kcuzner/pop-n-music-controller/README.md

# Pop 'n Music PSX Controller
### Kevin Cuzner

AVR-based controller for the Pop 'n Music game supporting both native and
emulator modes.

## Goals

* Recognized as a native controller by the PS1 version of the game
* Recognized as a valid controller by the emulated version of the game

## Notes

### Cable

* Yellow: ATT
* Red: VCC
* Black: GND
* Blue: CLK
* Orange: COMMAND
* Green: ACK
* Purple: DATA
