kcuzner/pop-n-music-controller/(commit log)

2013-08-03 Added initial schematic and kicad project
    [popnmusic.sch]
2013-08-05 Added methods for getting button status values
    [popnmusic.sch]
2013-08-05 Optimized c code for speed during interrupts...more still needed
2013-08-05 Added initial int0 vector in assembly
    The problem was that it appeared that it was taking too long to
    execute the interrupt handler in c and so the int0 interrupt would
    get called before int0 was called 8 times and reset the read mask.
    The solution was to write the ISR for INT0 in assembly, trying to
    optimize as best as possible to get the instructions. Also, the clock
    was changed to be a 20Mhz crystal to get us some more time. According
    to http://store.curiousinventor.com/guides/PS2/, for the PS1, the
    bus frequency is between 100Khz and 500Khz. This gives about 8-24 ish
    cycles before the next clock begins. In addition, the send queue was
    abandoned in favor of using a single byte and mask f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
    [psx.c, psx.h, psx_pins.h]
2013-08-05 Changed to use internal SPI for reading PSX bus
    Receive appears to pass the flash check when receiving 0x80
    It was discovered that 0x01 makes for 0x80, so it would appear the
    byte order is reversed
    [popnmusic.sch]
2013-08-05 Found the reverse data order flag and set it
    [main.c, psx.c]
2013-08-05 Switched oscillator back to 8Mhz internal R/C
    [popnmusic.sch]
2013-08-05 Added ack functionality which passes blink test
    The test here was to say ack on 0x01. If pd0 lit, it worked. Then,
    don't ack on 0x01. If pd0 didn't light, it worked.
    [main.c, psx.c, psx_pins.h]
2013-08-05 Changed command parsing structure and confirmed communication to pc
    Confirmation was by setting the two button bytes to 0x00 and seeing
    that all buttons were registered as off. Next, the button bytes were
    set to 0xff and it was seen that all the buttons were registered as
    pressed.
2013-08-05 Added button update method to main loop and sent button data
    Button update method was optimized to work decently fast. Before, we
    were missing keypresses. The newer method removes volatile
    restrictions and stuff. Hopefully it is also easier to read.
    [buttons.c, buttons.h, main.c, psx.h]
2013-08-05 Fixed polarity of button presses
    [buttons.c, main.c, psx.c]
2013-08-09 Added PSX controller button mapping from a real controller
2013-08-10 Moved button bit defs to the header and added second status LED
    [popnmusic.sch]
2013-08-10 Implemented mode switch via start + select
    The way it works is that when in emulator mode, PD0 is lit. When
    in PSX mode, PD1 is lit. Pressing both start and select causes both
    lights to be lit. After 3 seconds, if the buttons have not been
    released, the mode will be switched and the other LED that was not
    lit will be lit and the other one will be turned off.
2013-08-12 Fixed schematic to match what was actually assembled
    [popnmusic.sch]
2013-08-12 Added EEPROM functions for remembering the flag state of psx/emulator mode
    The controller now remembers what mode it was last set to so that it doesn't
    have to be switched every time it is turned on
    [main.c]
